jonthomasson/retro1/rev1.a/6502Computer2.png

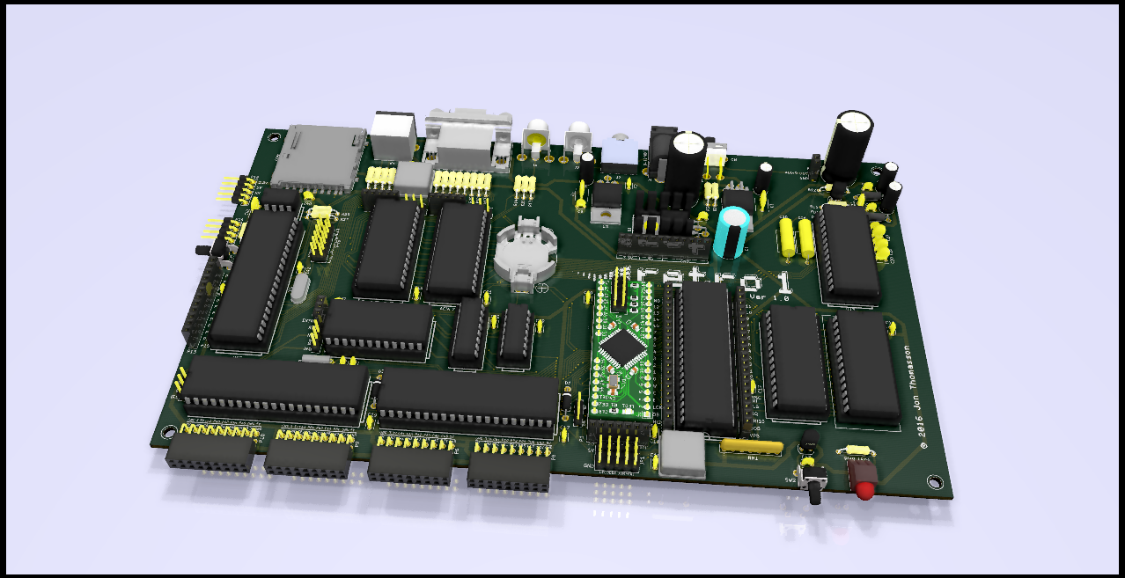
rev1.a/6502Computer2.png
