jonthomasson/retro1/rev1.a/6502Computer_raytraced.jpg

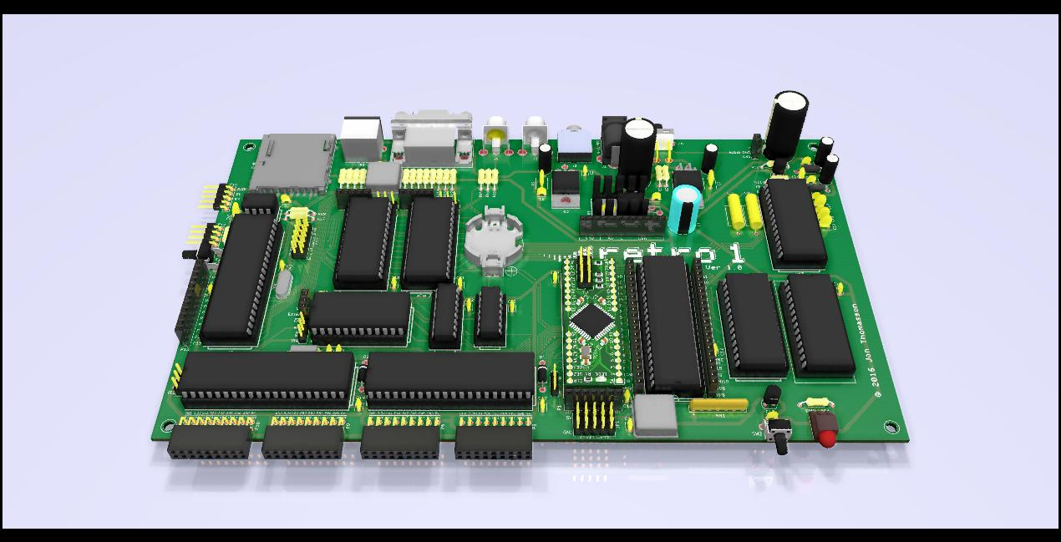
rev1.a/6502Computer_raytraced.jpg
