jonthomasson/retro1/rev1.a/3dfinished/6502Computer_0.png

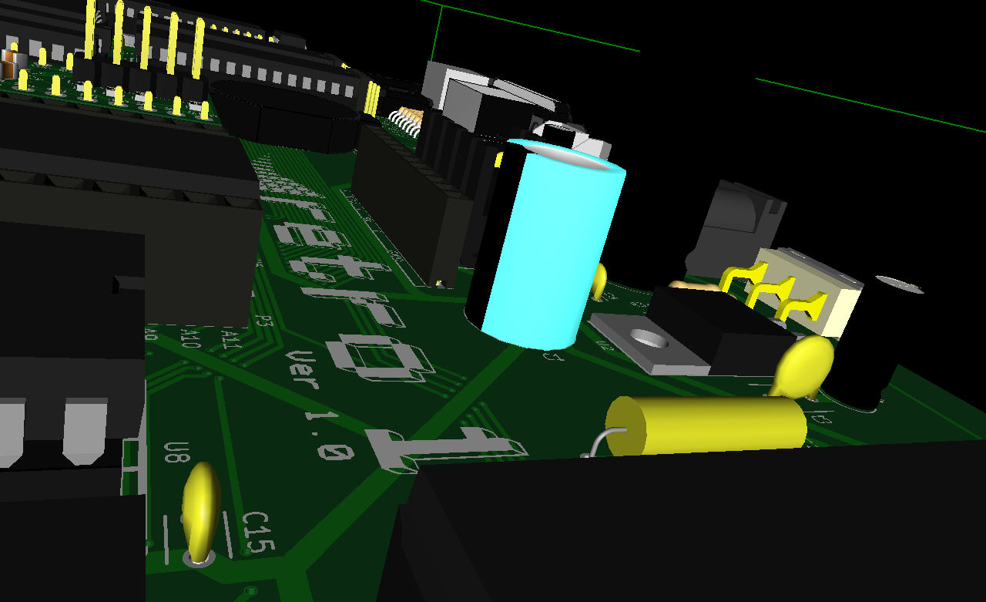
rev1.a/3dfinished/6502Computer_0.png
