jonthomasson/retro1/rev1.a/3dfinished/6502Computer_1.png

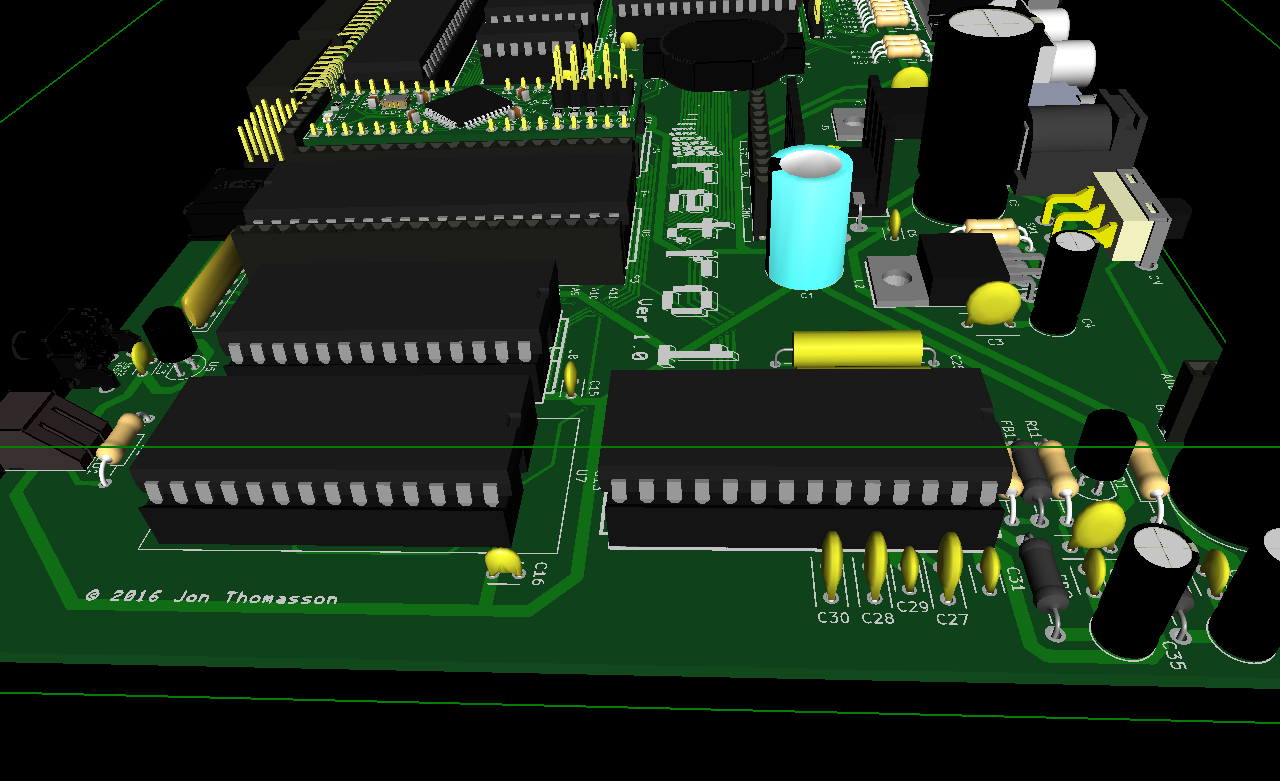
rev1.a/3dfinished/6502Computer_1.png
