jonthomasson/retro1/rev1.a/3dfinished/retro1_1.png

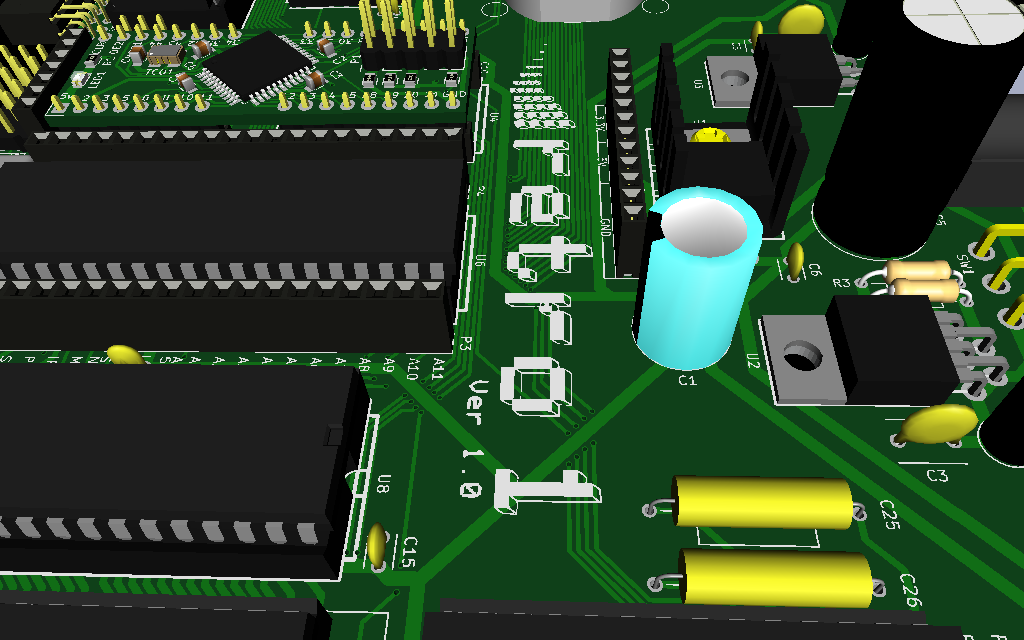
rev1.a/3dfinished/retro1_1.png
