jonthomasson/retro1/rev1.a/3dfinished/retro1_2.png

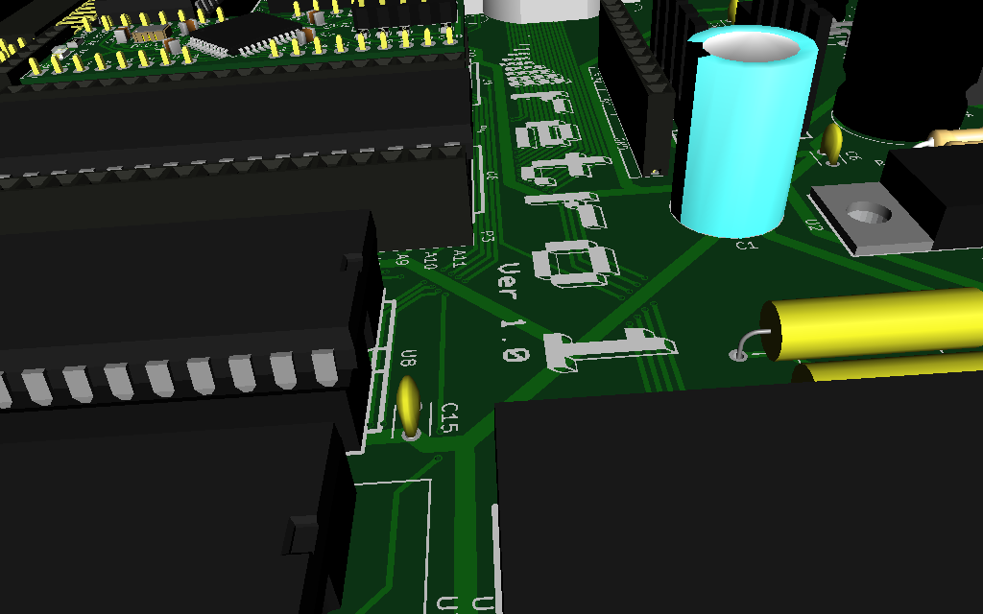
rev1.a/3dfinished/retro1_2.png
