jonthomasson/retro1/rev1.a/6502Computer.jpg

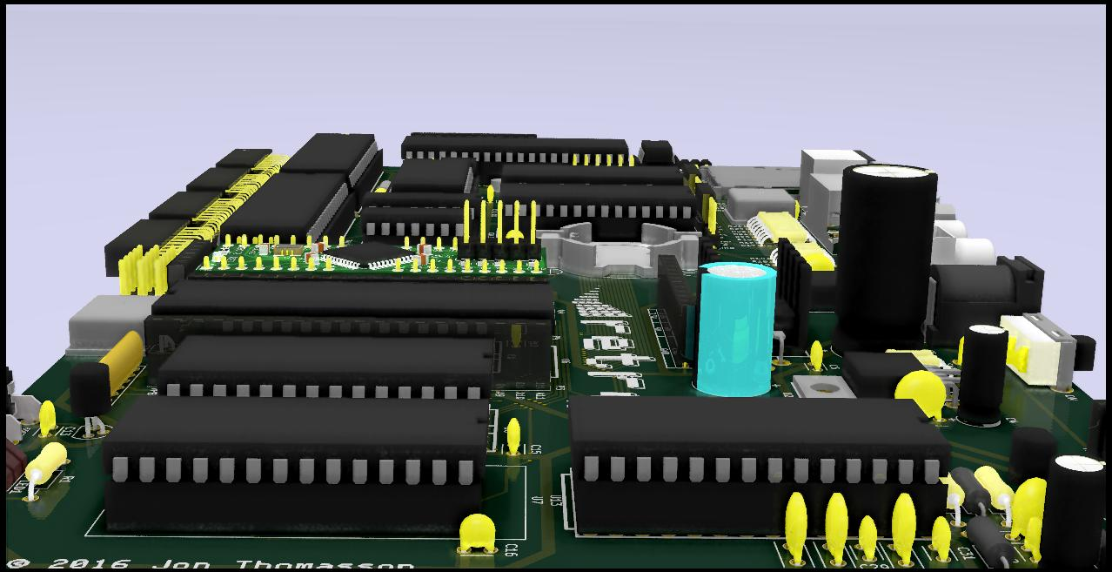
rev1.a/6502Computer.jpg
