jonthomasson/retro1/rev1.a/retro1.dxf

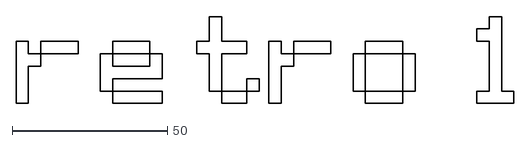
[picture p10: CAD file, 2017-04-14]
rev1.a/retro1.dxf
160.4 x 28.0
