jonthomasson/retro1/(list of files, cad)

Other CAD files:
rev1.a/3dfinished/retro1.dxf
