jonthomasson/retro1/software/retro1-tests/acia-test/screenshot.png

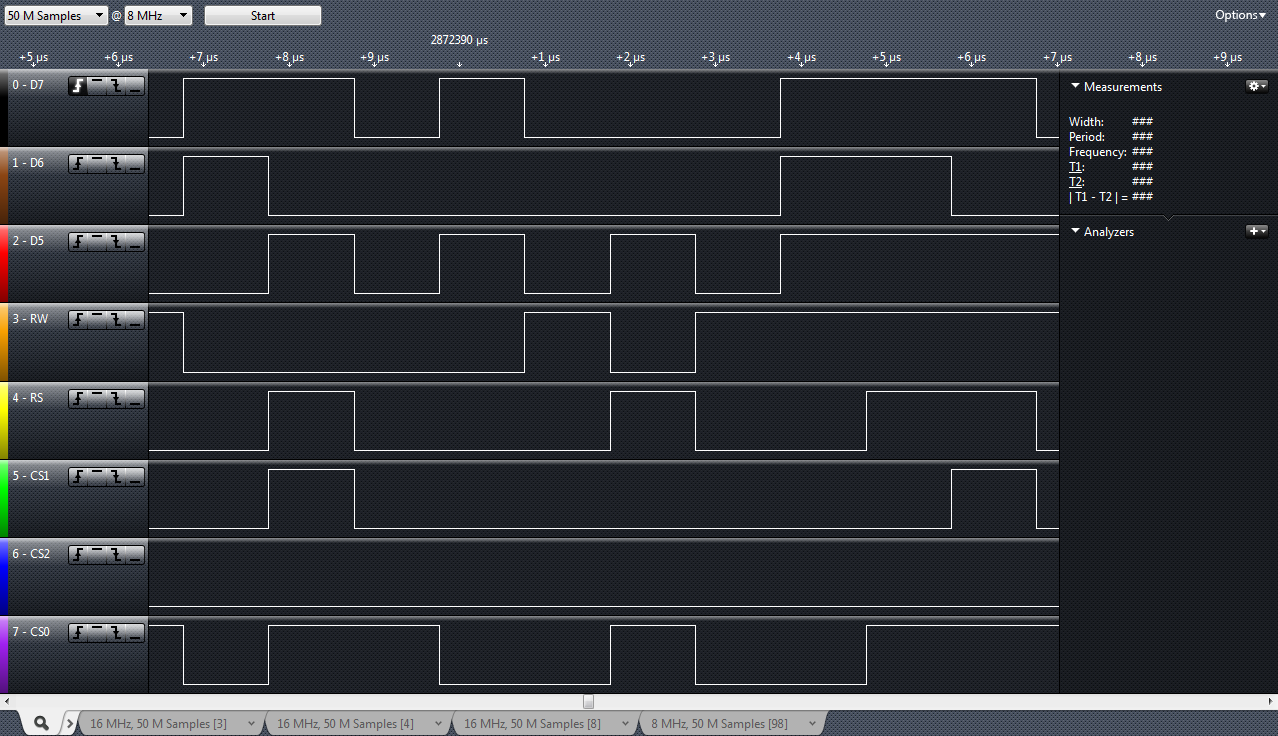
software/retro1-tests/acia-test/screenshot.png
