jonthomasson/retro1/rev1.a/6502Computer.kicad_pcb

## KiCad design rev1.a/6502Computer.kicad_pcb (2017-04-14)

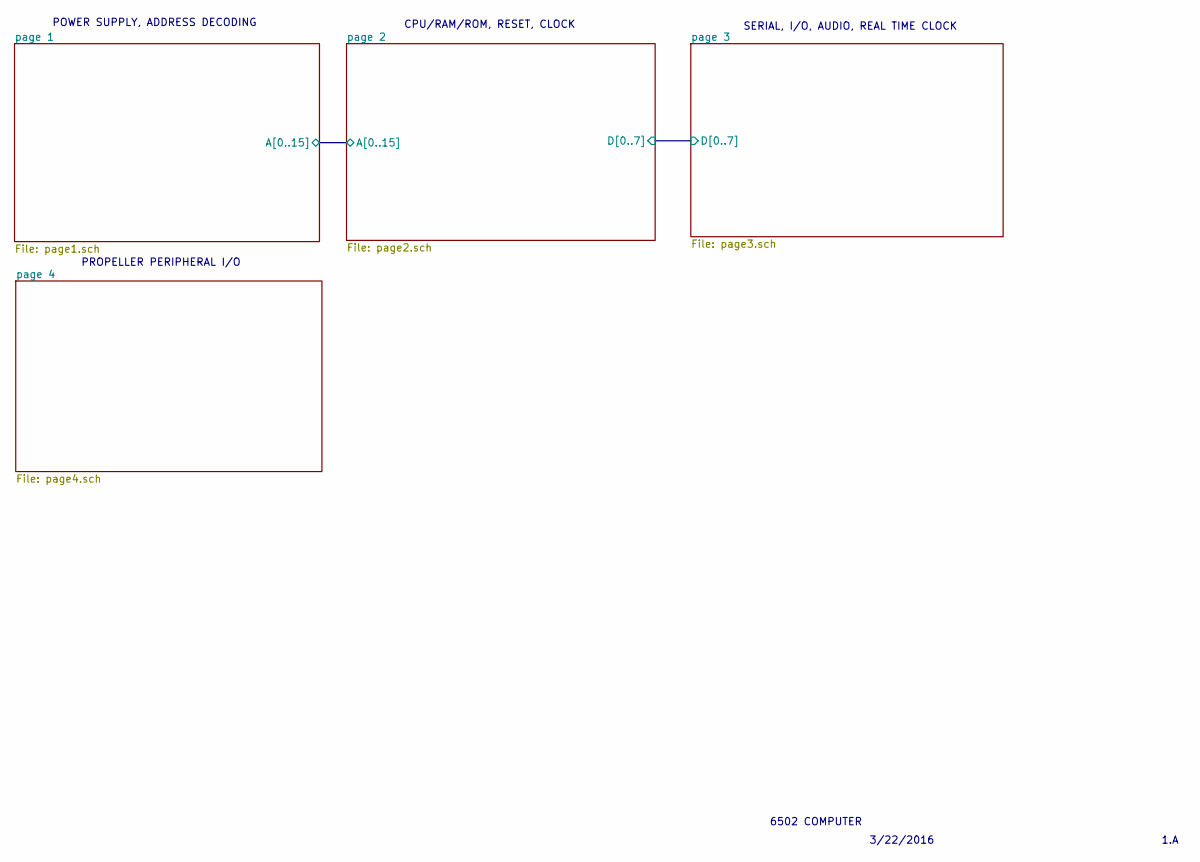
[picture p12: schematic 6502Computer.sch]

Notes on the sheet:
6502 COMPUTER
3/22/2016
1.A
POWER SUPPLY, ADDRESS DECODING
CPU/RAM/ROM, RESET, CLOCK
SERIAL, I/O, AUDIO, REAL TIME CLOCK
PROPELLER PERIPHERAL I/O

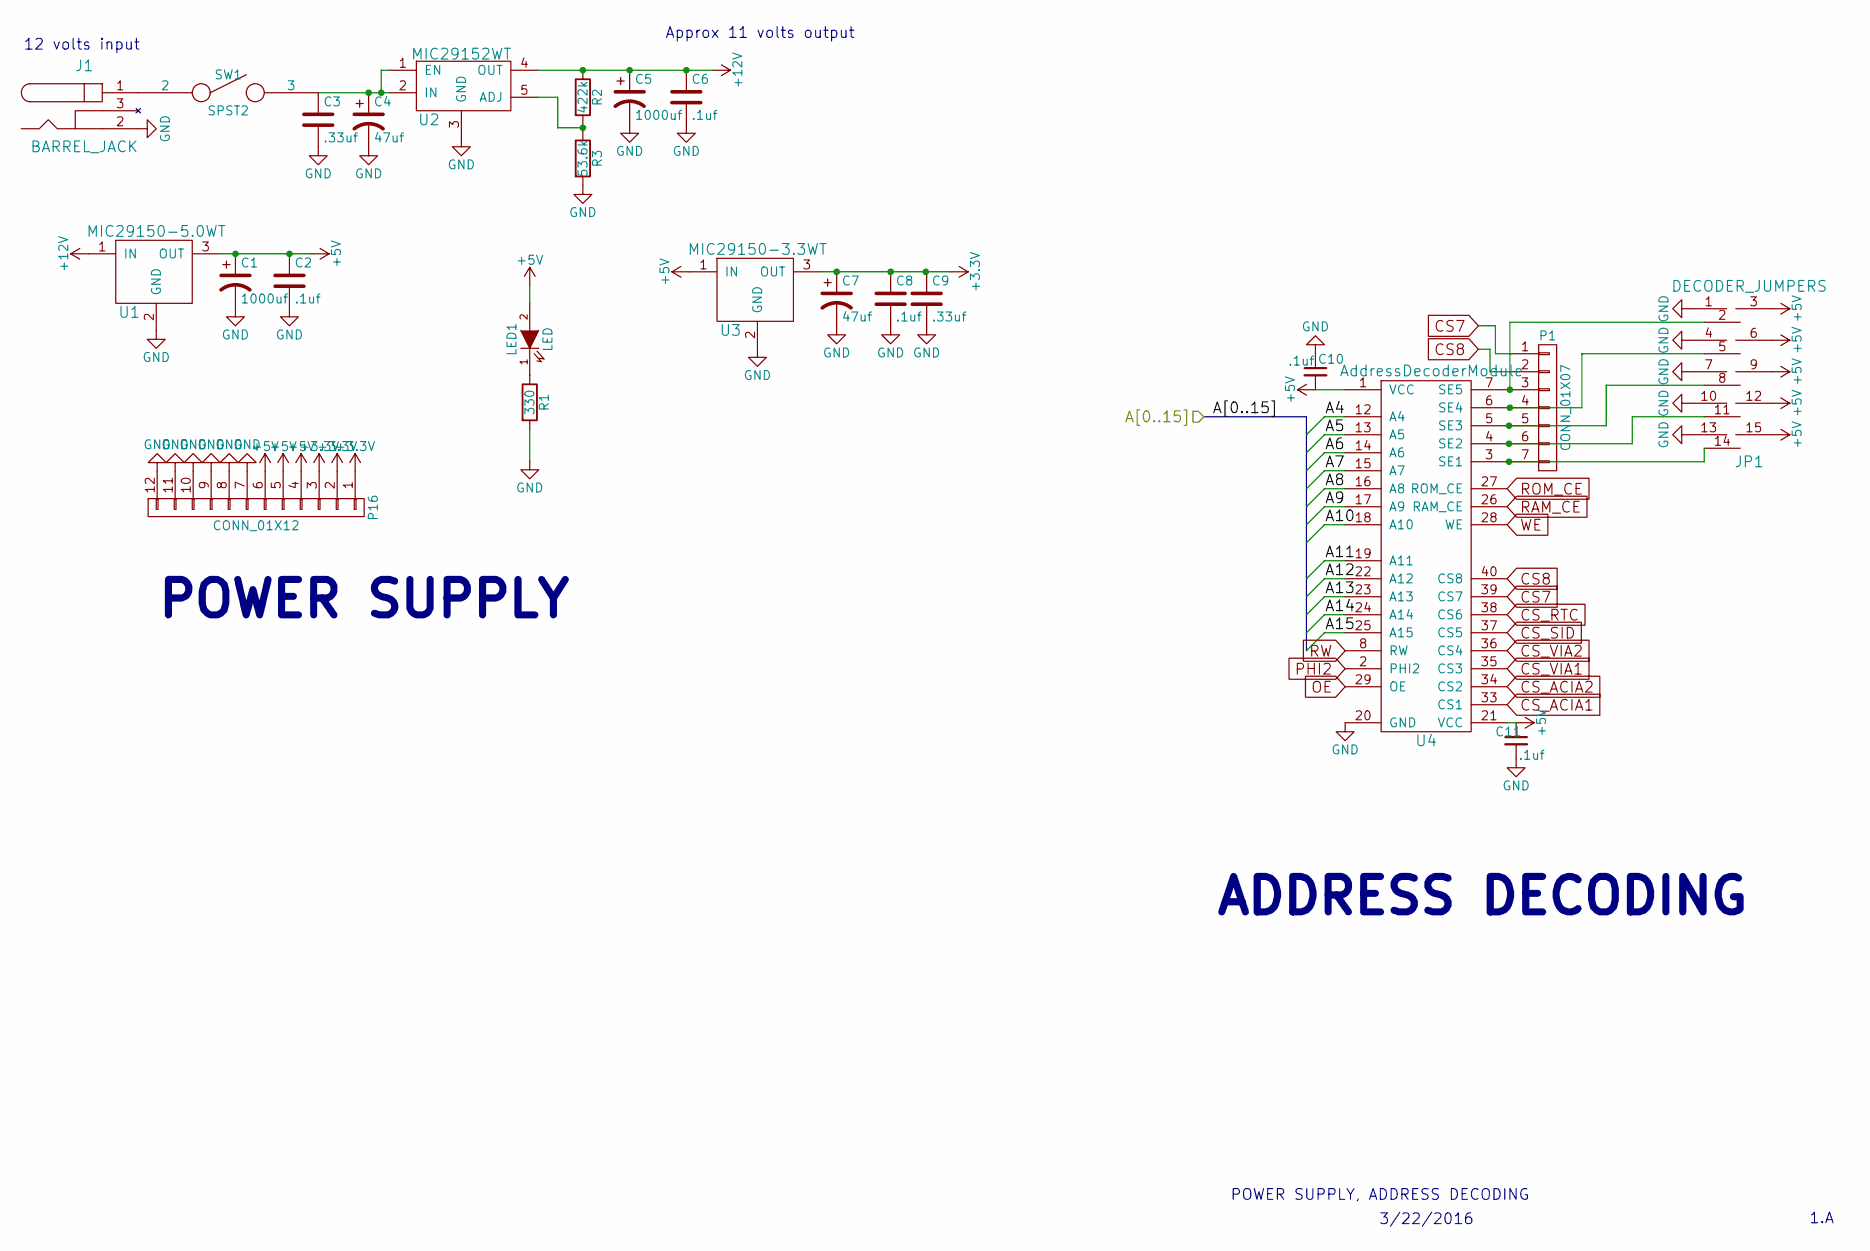
[picture p13: schematic page1.sch]

Parts:
C1: 1000uf; C_Radial_D10_L16_P5
C2, C6, C8, C10, C11: .1uf; C_Disc_D3_P2.5
C3, C9: .33uf; C_Disc_D6_P5
C4, C7: 47uf; C_Radial_D5_L11_P2
C5: 1000uf; C_Radial_D12.5_L25_P5
J1: BARREL_JACK; Barrel_Jack_PJ002A
JP1: DECODER_JUMPERS; Pin_Header_Straight_3x05
LED1: LED; WP1503CB_LED
P1: CONN_01X07; Socket_Strip_Straight_1x07
P16: CONN_01X12; Socket_Strip_Straight_1x12
R1: 330; Resistor_Horizontal_RM10mm
R2: 422k; Resistor_Horizontal_RM10mm
R3: 53.6k; Resistor_Horizontal_RM10mm
SW1: SPST2; SW_Micro_Right_Angle_SPST
U1: MIC29150-5.0WT; to220-horiz_5772
U2: MIC29152WT; to220-5-horiz-notab
U3: MIC29150-3.3WT; to220-horiz-notab
U4: AddressDecoderModule; Address_Decoder_CPLD2

Connections:
+3V3: C7.1, C8.1, C9.1, P16.1, P16.2, P16.3, U3.3 (OUT); also elsewhere on the board
+5V: C1.1, C2.1, C10.2, C11.1, JP1.3, JP1.6, JP1.9, JP1.12, JP1.15, LED1.2 (A), P16.4, P16.5, P16.6, U1.3 (OUT), U3.1 (IN), U4.1 (VCC), U4.21 (VCC); also elsewhere on the board
+12V: C5.1, C6.1, R2.1, U1.1 (IN), U2.4 (OUT); also elsewhere on the board
/page 1/A5: U4.13 (A5); also elsewhere on the board
/page 1/A6: U4.14 (A6); also elsewhere on the board
/page 1/A7: U4.15 (A7); also elsewhere on the board
/page 1/A8: U4.16 (A8); also elsewhere on the board
/page 1/A9: U4.17 (A9); also elsewhere on the board
/page 1/A10: U4.18 (A10); also elsewhere on the board
/page 1/A11: U4.19 (A11); also elsewhere on the board
/page 1/A12: U4.22 (A12); also elsewhere on the board
/page 1/A13: U4.23 (A13); also elsewhere on the board
/page 1/A14: U4.24 (A14); also elsewhere on the board
/page 1/A15: U4.25 (A15); also elsewhere on the board
A4: U4.12 (A4); also elsewhere on the board
CS7: P1.1, U4.39 (CS7)
CS8: P1.2, U4.40 (CS8)
CS_ACIA1: U4.33 (CS1); also elsewhere on the board
CS_ACIA2: U4.34 (CS2); also elsewhere on the board
CS_RTC: U4.38 (CS6); also elsewhere on the board
CS_SID: U4.37 (CS5); also elsewhere on the board
CS_VIA1: U4.35 (CS3); also elsewhere on the board
CS_VIA2: U4.36 (CS4); also elsewhere on the board
GND: C1.2, C2.2, C3.2, C4.2, C5.2, C6.2, C7.2, C8.2, C9.2, C10.1, C11.2, J1.2, JP1.1, JP1.4, JP1.7, JP1.10, JP1.13, P16.7, P16.8, P16.9, P16.10, P16.11, P16.12, R1.2, R3.2, U1.2 (GND), U2.3 (GND), U3.2 (GND), U4.20 (GND); also elsewhere on the board
unnamed: C3.1, C4.1, SW1.3, U2.1 (EN), U2.2 (IN)
unnamed: J1.1, SW1.2
unnamed: JP1.2, P1.3, U4.7 (SE5)
unnamed: JP1.5, P1.4, U4.6 (SE4)
unnamed: JP1.8, P1.5, U4.5 (SE3)
unnamed: JP1.11, P1.6, U4.4 (SE2)
unnamed: JP1.14, P1.7, U4.3 (SE1)
unnamed 105: LED1.1 (K), R1.1; also elsewhere on the board
unnamed: R2.2, R3.1, U2.5 (ADJ)
OE: U4.29 (OE); also elsewhere on the board
PHI2: U4.2 (PHI2); also elsewhere on the board
RAM_CE: U4.26 (RAM_CE); also elsewhere on the board
ROM_CE: U4.27 (ROM_CE); also elsewhere on the board
RW: U4.8 (RW); also elsewhere on the board
WE: U4.28 (WE); also elsewhere on the board

Notes on the sheet:
ADDRESS DECODING
POWER SUPPLY
Approx 11 volts output
12 volts input
POWER SUPPLY, ADDRESS DECODING
3/22/2016
1.A

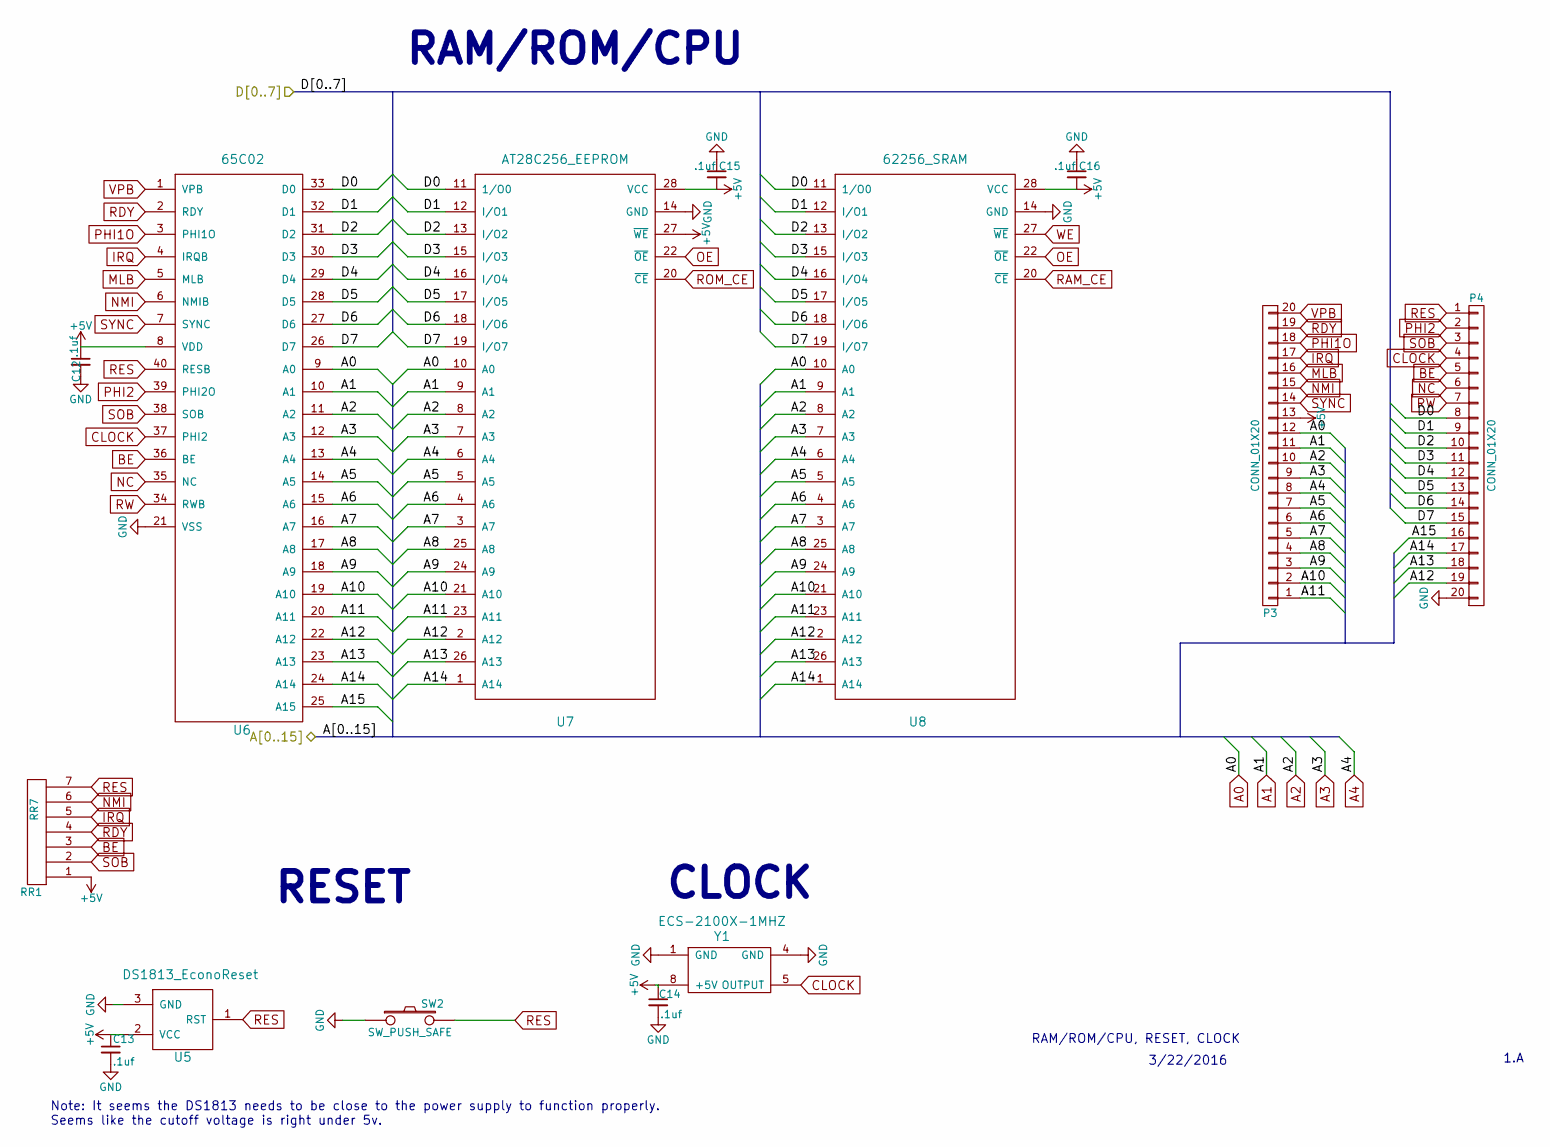
[picture p14: schematic page2.sch]

Parts:
C12, C13, C14, C15, C16: .1uf; C_Disc_D3_P2.5
P3, P4: CONN_01X20; Socket_Strip_Straight_1x20
RR1: RR7; 7_pin_resistor_network
SW2: SW_PUSH_SAFE; 1-1825027-1-TACTILE_SWITCH
U5: DS1813_EconoReset; TO-92_Molded_Narrow
U6: 65C02; dil_40-600_socket
U7: AT28C256_EEPROM; 28-526-11-SOCKET
U8: 62256_SRAM; dil_28-600_socket
Y1: ECS-2100X-1MHZ; ECS-2100AX

Connections:
+5V: C12.1, C13.1, C14.1, C15.2, C16.2, P3.13, RR1.1 (COM), U5.2 (VCC), U6.8 (VDD), U7.27 (~WE), U7.28 (VCC), U8.28 (VCC), Y1.8 (+5V); also elsewhere on the board
/page 1/A5: P3.7, U6.14 (A5), U7.5 (A5), U8.5 (A5); also elsewhere on the board
/page 1/A6: P3.6, U6.15 (A6), U7.4 (A6), U8.4 (A6); also elsewhere on the board
/page 1/A7: P3.5, U6.16 (A7), U7.3 (A7), U8.3 (A7); also elsewhere on the board
/page 1/A8: P3.4, U6.17 (A8), U7.25 (A8), U8.25 (A8); also elsewhere on the board
/page 1/A9: P3.3, U6.18 (A9), U7.24 (A9), U8.24 (A9); also elsewhere on the board
/page 1/A10: P3.2, U6.19 (A10), U7.21 (A10), U8.21 (A10); also elsewhere on the board
/page 1/A11: P3.1, U6.20 (A11), U7.23 (A11), U8.23 (A11); also elsewhere on the board
/page 1/A12: P4.19, U6.22 (A12), U7.2 (A12), U8.2 (A12); also elsewhere on the board
/page 1/A13: P4.18, U6.23 (A13), U7.26 (A13), U8.26 (A13); also elsewhere on the board
/page 1/A14: P4.17, U6.24 (A14), U7.1 (A14), U8.1 (A14); also elsewhere on the board
/page 1/A15: P4.16, U6.25 (A15); also elsewhere on the board
/page 2/D0: P4.8, U6.33 (D0), U7.11 (1/O0), U8.11 (1/O0); also elsewhere on the board
/page 2/D1: P4.9, U6.32 (D1), U7.12 (I/O1), U8.12 (I/O1); also elsewhere on the board
/page 2/D2: P4.10, U6.31 (D2), U7.13 (I/O2), U8.13 (I/O2); also elsewhere on the board
/page 2/D3: P4.11, U6.30 (D3), U7.15 (I/O3), U8.15 (I/O3); also elsewhere on the board
/page 2/D4: P4.12, U6.29 (D4), U7.16 (I/O4), U8.16 (I/O4); also elsewhere on the board
/page 2/D5: P4.13, U6.28 (D5), U7.17 (I/O5), U8.17 (I/O5); also elsewhere on the board
/page 2/D6: P4.14, U6.27 (D6), U7.18 (I/O6), U8.18 (I/O6); also elsewhere on the board
/page 2/D7: P4.15, U6.26 (D7), U7.19 (I/O7), U8.19 (I/O7); also elsewhere on the board
A0: P3.12, U6.9 (A0), U7.10 (A0), U8.10 (A0); also elsewhere on the board
A1: P3.11, U6.10 (A1), U7.9 (A1), U8.9 (A1); also elsewhere on the board
A2: P3.10, U6.11 (A2), U7.8 (A2), U8.8 (A2); also elsewhere on the board
A3: P3.9, U6.12 (A3), U7.7 (A3), U8.7 (A3); also elsewhere on the board
A4: P3.8, U6.13 (A4), U7.6 (A4), U8.6 (A4); also elsewhere on the board
BE: P4.5, RR1.3, U6.36 (BE)
CLOCK: P4.4, U6.37 (PHI2), Y1.5 (OUTPUT)
GND: C12.2, C13.2, C14.2, C15.1, C16.1, P4.20, SW2.1, U5.3 (GND), U6.21 (VSS), U7.14 (GND), U8.14 (GND), Y1.1 (GND), Y1.4 (GND); also elsewhere on the board
IRQ: P3.17, RR1.5, U6.4 (IRQB); also elsewhere on the board
MLB: P3.16, U6.5 (MLB)
NC: P4.6, U6.35 (NC)
NMI: P3.15, RR1.6, U6.6 (NMIB); also elsewhere on the board
OE: U7.22 (~OE), U8.22 (~OE); also elsewhere on the board
PHI1O: P3.18, U6.3 (PHI1O)
PHI2: P4.2, U6.39 (PHI2O); also elsewhere on the board
RAM_CE: U8.20 (~CE); also elsewhere on the board
RDY: P3.19, RR1.4, U6.2 (RDY)
RES: P4.1, RR1.7, SW2.4, U5.1 (RST), U6.40 (RESB); also elsewhere on the board
ROM_CE: U7.20 (~CE); also elsewhere on the board
RW: P4.7, U6.34 (RWB); also elsewhere on the board
SOB: P4.3, RR1.2, U6.38 (SOB)
SYNC: P3.14, U6.7 (SYNC)
VPB: P3.20, U6.1 (VPB)
WE: U8.27 (~WE); also elsewhere on the board

Notes on the sheet:
RAM/ROM/CPU
CLOCK
RESET
Note: It seems the DS1813 needs to be close to the power supply to function properly. Seems like the cutoff voltage is right under 5v.
RAM/ROM/CPU, RESET, CLOCK
3/22/2016
1.A

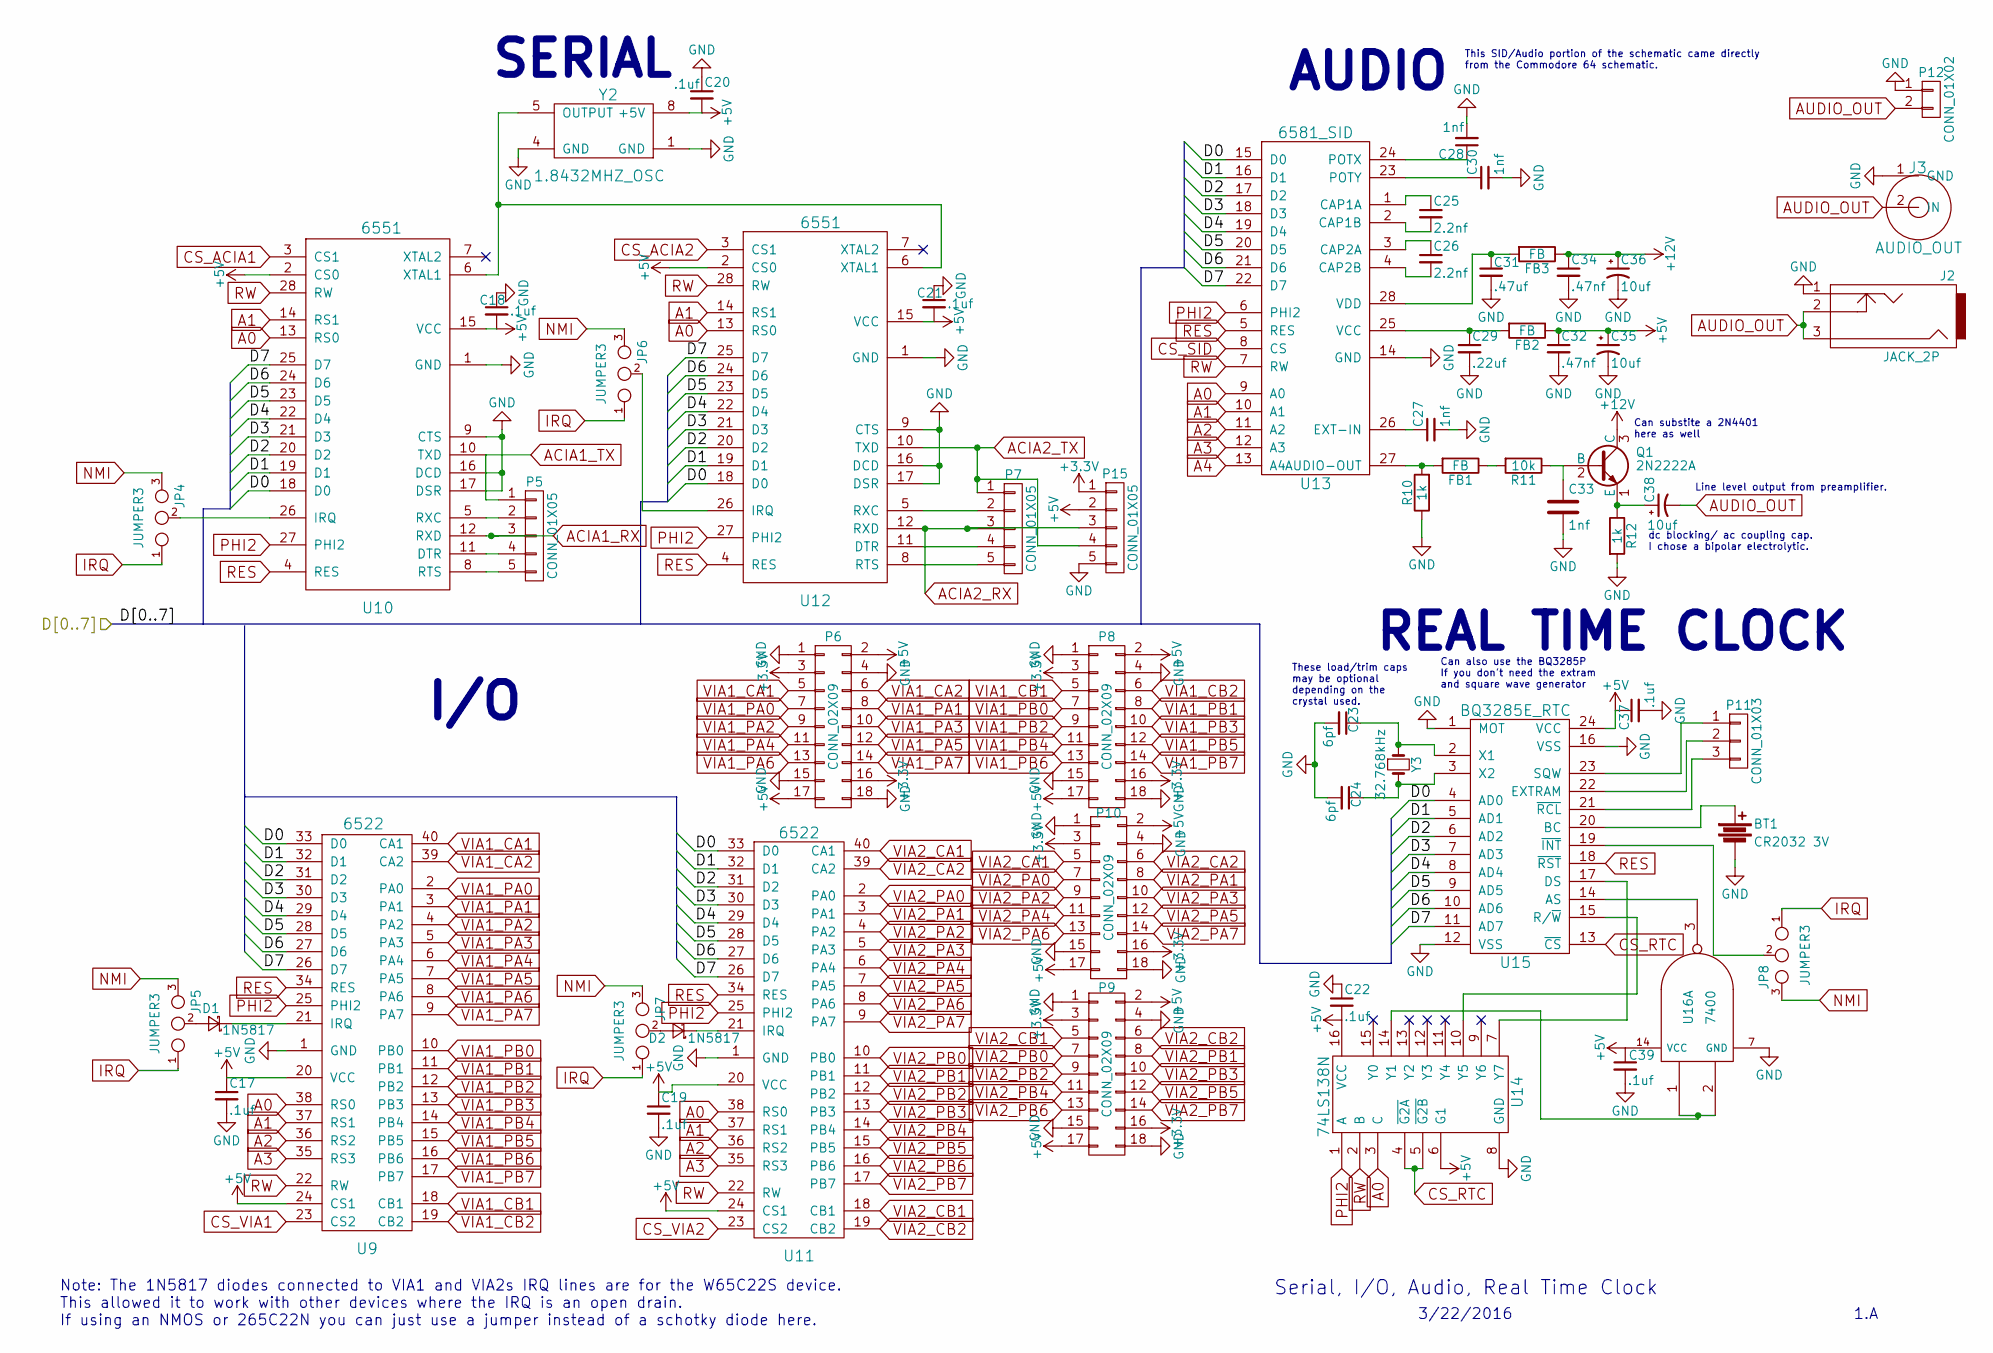
[picture p15: schematic page3.sch]

Parts:
BT1: CR2032 3V; BU2032SM
C17, C18, C19, C20, C21, C22, C37, C39: .1uf; C_Disc_D3_P2.5
C23, C24: 6pf; C_Disc_D3_P2.5
C25, C26: 2.2nf; C_Axial_D6_L11_P18
C27, C28, C30, C33: 1nf; C_Disc_D6_P3.5_Skinny
C29: .22uf; C_Disc_D3_P2.5
C31: .47uf; C_Disc_D3_P2.5
C32, C34: .47nf; C_Disc_D3_P2.5
C35, C36: 10uf; C_Radial_D5_L11_P2
C38: 10uf; C_Radial_D12.5_L25_P5
D1, D2: 1N5817; diode_do41
FB1, FB2, FB3: FB; Ferrite_Bead_Horizontal_RM10mm
J2: JACK_2P; SJ13525NHeadphone
J3: AUDIO_OUT; RCJ013AUDIO
JP4, JP5, JP6, JP7, JP8: JUMPER3; Pin_Header_Straight_1x03
P5, P7: CONN_01X05; Socket_Strip_Straight_1x05
P6, P8, P9, P10: CONN_02X09; Socket_Strip_Angled_2x09
P11: CONN_01X03; Socket_Strip_Straight_1x03
P12: CONN_01X02; Socket_Strip_Straight_1x02
P15: CONN_01X05; Pin_Header_Angled_1x05
Q1: 2N2222A; TO-92_Molded_Narrow
R10, R12: 1k; Resistor_Horizontal_RM10mm
R11: 10k; Resistor_Horizontal_RM10mm
U9, U11: 6522; dil_40-600_socket
U10, U12: 6551; dil_28-600_socket
U13: 6581_SID; dil_28-600_socket
U14: 74LS138N; dil_16-300_socket
U15: BQ3285E_RTC; dil_24-600_socket
U16: 7400; dil_14-300_socket
Y2: 1.8432MHZ_OSC; ECS-2100AX
Y3: 32.768kHz; crystal_tc-38_horiz

Connections:
+3V3: P6.3, P6.16, P8.3, P8.16, P9.3, P9.16, P10.3, P10.16, P15.1; also elsewhere on the board
+5V: C17.1, C18.2, C19.1, C20.2, C21.2, C22.2, C32.1, C35.1, C37.1, C39.1, FB2.1, P6.2, P6.17, P8.2, P8.17, P9.2, P9.17, P10.2, P10.17, P15.2, U9.20 (VCC), U9.24 (CS1), U10.2 (CS0), U10.15 (VCC), U11.20 (VCC), U11.24 (CS1), U12.2 (CS0), U12.15 (VCC), U14.6 (G1), U14.16 (VCC), U15.24 (VCC), U16.14 (VCC), Y2.8 (+5V); also elsewhere on the board
+12V: C34.1, C36.1, FB3.1, Q1.3 (C); also elsewhere on the board
/page 2/D0: U9.33 (D0), U10.18 (D0), U11.33 (D0), U12.18 (D0), U13.15 (D0), U15.4 (AD0); also elsewhere on the board
/page 2/D1: U9.32 (D1), U10.19 (D1), U11.32 (D1), U12.19 (D1), U13.16 (D1), U15.5 (AD1); also elsewhere on the board
/page 2/D2: U9.31 (D2), U10.20 (D2), U11.31 (D2), U12.20 (D2), U13.17 (D2), U15.6 (AD2); also elsewhere on the board
/page 2/D3: U9.30 (D3), U10.21 (D3), U11.30 (D3), U12.21 (D3), U13.18 (D3), U15.7 (AD3); also elsewhere on the board
/page 2/D4: U9.29 (D4), U10.22 (D4), U11.29 (D4), U12.22 (D4), U13.19 (D4), U15.8 (AD4); also elsewhere on the board
/page 2/D5: U9.28 (D5), U10.23 (D5), U11.28 (D5), U12.23 (D5), U13.20 (D5), U15.9 (AD5); also elsewhere on the board
/page 2/D6: U9.27 (D6), U10.24 (D6), U11.27 (D6), U12.24 (D6), U13.21 (D6), U15.10 (AD6); also elsewhere on the board
/page 2/D7: U9.26 (D7), U10.25 (D7), U11.26 (D7), U12.25 (D7), U13.22 (D7), U15.11 (AD7); also elsewhere on the board
A0: U9.38 (RS0), U10.13 (RS0), U11.38 (RS0), U12.13 (RS0), U13.9 (A0), U14.3 (C); also elsewhere on the board
A1: U9.37 (RS1), U10.14 (RS1), U11.37 (RS1), U12.14 (RS1), U13.10 (A1); also elsewhere on the board
A2: U9.36 (RS2), U11.36 (RS2), U13.11 (A2); also elsewhere on the board
A3: U9.35 (RS3), U11.35 (RS3), U13.12 (A3); also elsewhere on the board
A4: U13.13 (A4); also elsewhere on the board
ACIA1_RX: P5.3, U10.12 (RXD); also elsewhere on the board
ACIA1_TX: P5.1, U10.10 (TXD); also elsewhere on the board
ACIA2_RX: P7.3, P15.3, U12.12 (RXD); also elsewhere on the board
ACIA2_TX: P7.1, P15.4, U12.10 (TXD); also elsewhere on the board
AUDIO_OUT: C38.2, J2.2, J2.3, J3.2 (IN), P12.2
CS_RTC: U14.4 (~G2A), U14.5 (~G2B), U15.13 (~CS); also elsewhere on the board
CS_SID: U13.8 (CS); also elsewhere on the board
CS_VIA1: U9.23 (CS2); also elsewhere on the board
CS_VIA2: U11.23 (CS2); also elsewhere on the board
GND: BT1.2, C17.2, C18.1, C19.2, C20.1, C21.1, C22.1, C23.2, C24.2, C27.2, C28.2, C29.2, C30.2, C31.2, C32.2, C33.2, C34.2, C35.2, C36.2, C37.2, C39.2, J2.1, J3.1 (GND), P6.1, P6.4, P6.15, P6.18, P8.1, P8.4, P8.15, P8.18, P9.1, P9.4, P9.15, P9.18, P10.1, P10.4, P10.15, P10.18, P12.1, P15.5, R10.1, R12.2, U9.1 (GND), U10.1 (GND), U10.9 (CTS), U10.16 (DCD), U10.17 (DSR), U11.1 (GND), U12.1 (GND), U12.9 (CTS), U12.16 (DCD), U12.17 (DSR), U13.14 (GND), U14.8 (GND), U15.1 (MOT), U15.12 (VSS), U15.16 (VSS), U16.7 (GND), Y2.1 (GND), Y2.4 (GND); also elsewhere on the board
IRQ: JP4.1, JP5.1, JP6.1, JP7.1, JP8.1; also elsewhere on the board
NMI: JP4.3, JP5.3, JP6.3, JP7.3, JP8.3; also elsewhere on the board
unnamed: BT1.1, U15.20 (BC)
unnamed: C23.1, U15.2 (X1), Y3.1
unnamed: C24.1, U15.3 (X2), Y3.2
unnamed: C25.1, U13.1 (CAP1A)
unnamed: C25.2, U13.2 (CAP1B)
unnamed: C26.1, U13.3 (CAP2A)
unnamed: C26.2, U13.4 (CAP2B)
unnamed: C27.1, U13.26 (EXT-IN)
unnamed: C28.1, U13.24 (POTX)
unnamed: C29.1, FB2.2, U13.25 (VCC)
unnamed: C30.1, U13.23 (POTY)
unnamed: C31.1, FB3.2, U13.28 (VDD)
unnamed: C33.1, Q1.2 (B), R11.1
unnamed: C38.1, Q1.1 (E), R12.1
unnamed: D1.1 (K), U9.21 (IRQ)
unnamed: D1.2 (A), JP5.2
unnamed: D2.1 (K), U11.21 (IRQ)
unnamed: D2.2 (A), JP7.2
unnamed: FB1.1, R11.2
unnamed: FB1.2, R10.2, U13.27 (AUDIO-OUT)
unnamed 91: JP4.2, U10.26 (IRQ); also elsewhere on the board
unnamed 92: JP6.2, U12.26 (IRQ); also elsewhere on the board
unnamed: JP8.2, U15.19 (~INT)
unnamed 106: P5.2, U10.5 (RXC); also elsewhere on the board
unnamed 107: P5.4, U10.11 (DTR); also elsewhere on the board
unnamed 108: P5.5, U10.8 (RTS); also elsewhere on the board
unnamed 109: P7.2, U12.5 (RXC); also elsewhere on the board
unnamed 110: P7.4, U12.11 (DTR); also elsewhere on the board
unnamed 111: P7.5, U12.8 (RTS); also elsewhere on the board
unnamed: P11.1, U15.23 (SQW)
unnamed: P11.2, U15.22 (EXTRAM)
unnamed: P11.3, U15.21 (~RCL)
unnamed 137: U10.6 (XTAL1), U12.6 (XTAL1), Y2.5 (OUTPUT); also elsewhere on the board
unnamed: U14.7 (Y7), U15.17 (DS)
unnamed: U14.10 (Y5), U15.15 (R/~W)
unnamed: U14.14 (Y1), U16.1, U16.2
unnamed: U15.14 (AS), U16.3
PHI2: U9.25 (PHI2), U10.27 (PHI2), U11.25 (PHI2), U12.27 (PHI2), U13.6 (PHI2), U14.1 (A); also elsewhere on the board
RES: U9.34 (RES), U10.4 (RES), U11.34 (RES), U12.4 (RES), U13.5 (RES), U15.18 (~RST); also elsewhere on the board
RW: U9.22 (RW), U10.28 (RW), U11.22 (RW), U12.28 (RW), U13.7 (RW), U14.2 (B); also elsewhere on the board
VIA1_CA1: P6.5, U9.40 (CA1)
VIA1_CA2: P6.6, U9.39 (CA2)
VIA1_CB1: P8.5, U9.18 (CB1)
VIA1_CB2: P8.6, U9.19 (CB2)
VIA1_PA0: P6.7, U9.2 (PA0)
VIA1_PA1: P6.8, U9.3 (PA1)
VIA1_PA2: P6.9, U9.4 (PA2)
VIA1_PA3: P6.10, U9.5 (PA3)
VIA1_PA4: P6.11, U9.6 (PA4)
VIA1_PA5: P6.12, U9.7 (PA5)
VIA1_PA6: P6.13, U9.8 (PA6)
VIA1_PA7: P6.14, U9.9 (PA7)
VIA1_PB0: P8.7, U9.10 (PB0)
VIA1_PB1: P8.8, U9.11 (PB1)
VIA1_PB2: P8.9, U9.12 (PB2)
VIA1_PB3: P8.10, U9.13 (PB3)
VIA1_PB4: P8.11, U9.14 (PB4)
VIA1_PB5: P8.12, U9.15 (PB5)
VIA1_PB6: P8.13, U9.16 (PB6)
VIA1_PB7: P8.14, U9.17 (PB7)
VIA2_CA1: P10.5, U11.40 (CA1)
VIA2_CA2: P10.6, U11.39 (CA2)
VIA2_CB1: P9.5, U11.18 (CB1)
VIA2_CB2: P9.6, U11.19 (CB2)
VIA2_PA0: P10.7, U11.2 (PA0)
VIA2_PA1: P10.8, U11.3 (PA1)
VIA2_PA2: P10.9, U11.4 (PA2)
VIA2_PA3: P10.10, U11.5 (PA3)
VIA2_PA4: P10.11, U11.6 (PA4)
VIA2_PA5: P10.12, U11.7 (PA5)
VIA2_PA6: P10.13, U11.8 (PA6)
VIA2_PA7: P10.14, U11.9 (PA7)
VIA2_PB0: P9.7, U11.10 (PB0)
VIA2_PB1: P9.8, U11.11 (PB1)
VIA2_PB2: P9.9, U11.12 (PB2)
VIA2_PB3: P9.10, U11.13 (PB3)
VIA2_PB4: P9.11, U11.14 (PB4)
VIA2_PB5: P9.12, U11.15 (PB5)
VIA2_PB6: P9.13, U11.16 (PB6)
VIA2_PB7: P9.14, U11.17 (PB7)

Notes on the sheet:
AUDIO
I/O
SERIAL
REAL TIME CLOCK
Note: The 1N5817 diodes connected to VIA1 and VIA2s IRQ lines are for the W65C22S device. This allowed it to work with other devices where the IRQ is an open drain. If using an NMOS or 265C22N you can just use a jumper instead of a schotky diode here.
Can substite a 2N4401 here as well
Can also use the BQ3285P If you don't need the extram and square wave generator
This SID/Audio portion of the schematic came directly from the Commodore 64 schematic.
These load/trim caps may be optional depending on the crystal used.
Serial, I/O, Audio, Real Time Clock
3/22/2016
1.A
dc blocking/ ac coupling cap. I chose a bipolar electrolytic.
Line level output from preamplifier.

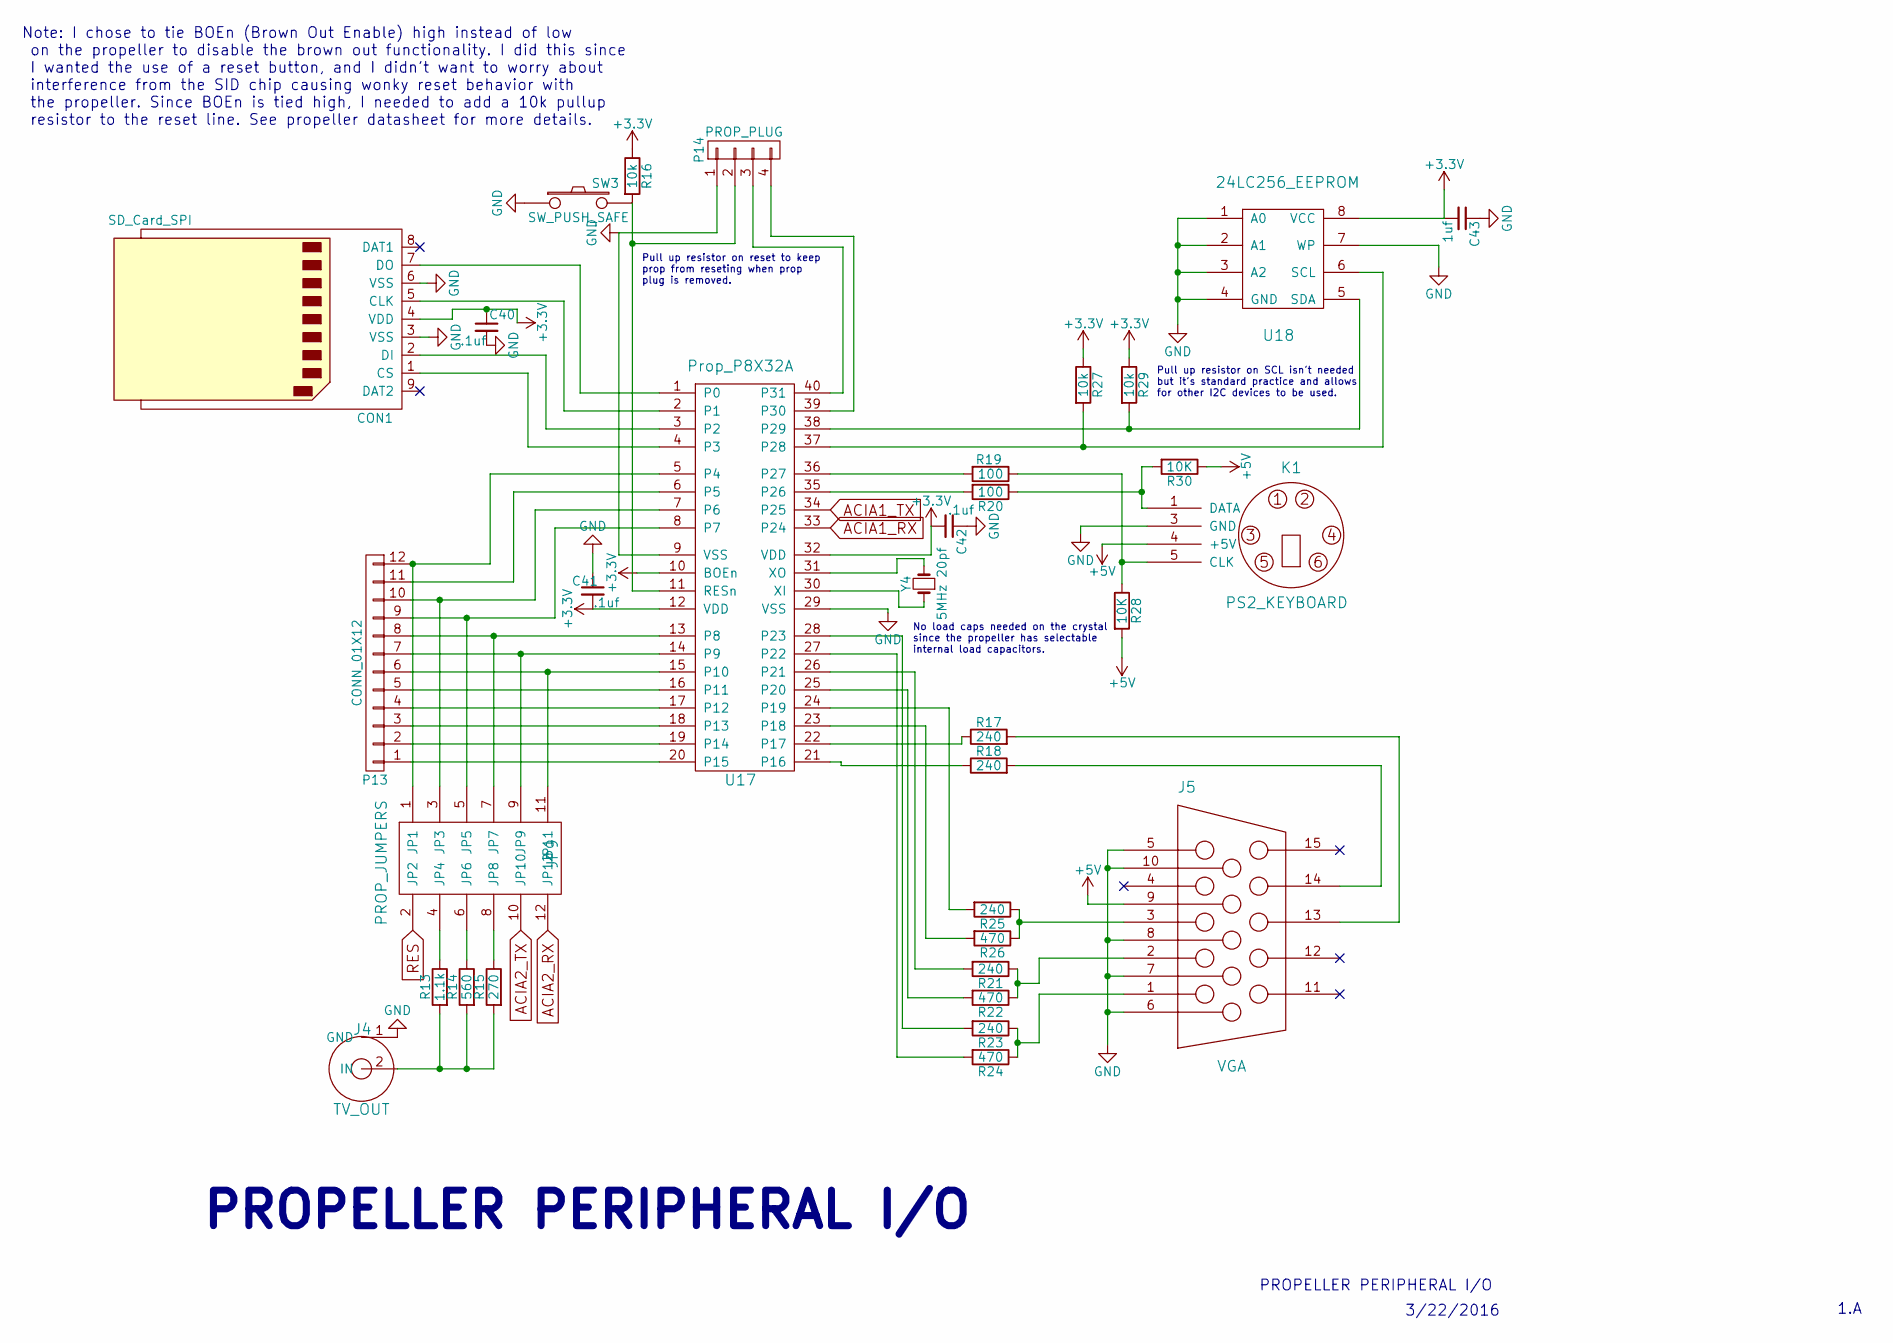
[picture p16: schematic page4.sch]

Parts:
C40, C41, C42: .1uf; C_Disc_D3_P2.5
C43: 1uf; C_Disc_D6_P5
CON1: SD_Card_SPI; DM1AASFPEJ_SDCARD
J4: TV_OUT; RCJ014VIDEO
J5: VGA; 117343442VGA
JP9: PROP_JUMPERS; Pin_Header_Straight_2x06
K1: PS2_KEYBOARD; MD60SM
P13: CONN_01X12; Socket_Strip_Straight_1x12
P14: PROP_PLUG
R13: 1.1k; Resistor_Horizontal_RM10mm
R14: 560; Resistor_Horizontal_RM10mm
R15: 270; Resistor_Horizontal_RM10mm
R16, R27, R29: 10k; Resistor_Horizontal_RM10mm
R17, R18, R21, R23, R25: 240; Resistor_Horizontal_RM10mm
R19, R20: 100; Resistor_Horizontal_RM10mm
R22, R24, R26: 470; Resistor_Horizontal_RM10mm
R28, R30: 10K; Resistor_Horizontal_RM10mm
SW3: SW_PUSH_SAFE; 1-1825027-1-TACTILE_SWITCH
U17: Prop_P8X32A; dil_40-600_socket
U18: 24LC256_EEPROM; dil_8-300_socket
Y4: 5MHz 20pf; crystal_hc-49s

Connections:
+3V3: C40.1, C41.2, C42.2, C43.2, CON1.4 (VDD), R16.1, R27.1, R29.1, U17.10 (BOEn), U17.12 (VDD), U17.32 (VDD), U18.8 (VCC); also elsewhere on the board
+5V: J5.9 (KEY/PWR), K1.4 (+5V), R28.2, R30.1; also elsewhere on the board
ACIA1_RX: U17.33 (P24); also elsewhere on the board
ACIA1_TX: U17.34 (P25); also elsewhere on the board
ACIA2_RX: JP9.12 (JP12); also elsewhere on the board
ACIA2_TX: JP9.10 (JP10); also elsewhere on the board
GND: C40.2, C41.1, C42.1, C43.1, CON1.3 (VSS), CON1.6 (VSS), J4.1 (GND), J5.5 (GND_HSYNC), J5.6 (RED_RTN), J5.7 (GREEN_RTN), J5.8 (BLUE_RTN), J5.10 (GND_VSYNC), K1.3 (GND), P14.1, SW3.1, U17.9 (VSS), U17.29 (VSS), U18.1 (A0), U18.2 (A1), U18.3 (A2), U18.4 (GND), U18.7 (WP); also elsewhere on the board
unnamed: CON1.1 (CS), U17.4 (P3)
unnamed: CON1.2 (DI), U17.3 (P2)
unnamed: CON1.5 (CLK), U17.2 (P1)
unnamed: CON1.7 (DO), U17.1 (P0)
unnamed: J4.2 (IN), R13.2, R14.2, R15.2
unnamed: J5.1 (RED), R23.1, R24.1
unnamed: J5.2 (GREEN), R21.1, R22.1
unnamed: J5.3 (BLUE), R25.1, R26.1
unnamed: J5.13 (HSYNC), R17.2
unnamed: J5.14 (VSYNC), R18.2
unnamed: JP9.1 (JP1), P13.12, U17.5 (P4)
unnamed: JP9.3 (JP3), P13.10, U17.7 (P6)
unnamed: JP9.4 (JP4), R13.1
unnamed: JP9.5 (JP5), P13.9, U17.8 (P7)
unnamed: JP9.6 (JP6), R14.1
unnamed: JP9.7 (JP7), P13.8, U17.13 (P8)
unnamed: JP9.8 (JP8), R15.1
unnamed: JP9.9 (JP9), P13.7, U17.14 (P9)
unnamed: JP9.11 (JP11), P13.6, U17.15 (P10)
unnamed: K1.1 (DATA), R20.1, R30.2
unnamed: K1.5 (CLK), R19.1, R28.1
unnamed: P13.1, U17.20 (P15)
unnamed: P13.2, U17.19 (P14)
unnamed: P13.3, U17.18 (P13)
unnamed: P13.4, U17.17 (P12)
unnamed: P13.5, U17.16 (P11)
unnamed: P13.11, U17.6 (P5)
unnamed: P14.2, R16.2, SW3.4, U17.11 (RESn)
unnamed: P14.3, U17.40 (P31)
unnamed: P14.4, U17.39 (P30)
unnamed: R17.1, U17.22 (P17)
unnamed: R18.1, U17.21 (P16)
unnamed: R19.2, U17.36 (P27)
unnamed: R20.2, U17.35 (P26)
unnamed: R21.2, U17.26 (P21)
unnamed: R22.2, U17.25 (P20)
unnamed: R23.2, U17.28 (P23)
unnamed: R24.2, U17.27 (P22)
unnamed: R25.2, U17.24 (P19)
unnamed: R26.2, U17.23 (P18)
unnamed: R27.2, U17.37 (P28), U18.6 (SCL)
unnamed: R29.2, U17.38 (P29), U18.5 (SDA)
unnamed: U17.30 (XI), Y4.1
unnamed: U17.31 (XO), Y4.2
RES: JP9.2 (JP2); also elsewhere on the board

Notes on the sheet:
PROPELLER PERIPHERAL I/O
Note: I chose to tie BOEn (Brown Out Enable) high instead of low on the propeller to disable the brown out functionality. I did this since I wanted the use of a reset button, and I didn't want to worry about interference from the SID chip causing wonky reset behavior with the propeller. Since BOEn 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
No load caps needed on the crystal since the propeller has selectable internal load capacitors.
Pull up resistor on SCL isn't needed but it's standard practice and allows for other I2C devices to be used.
Pull up resistor on reset to keep prop from reseting when prop plug is removed.
3/22/2016
1.A
