jonthomasson/retro1/rev1.a/6502Computer.kicad_pcb

## KiCad design rev1.a/6502Computer.kicad_pcb (continued)

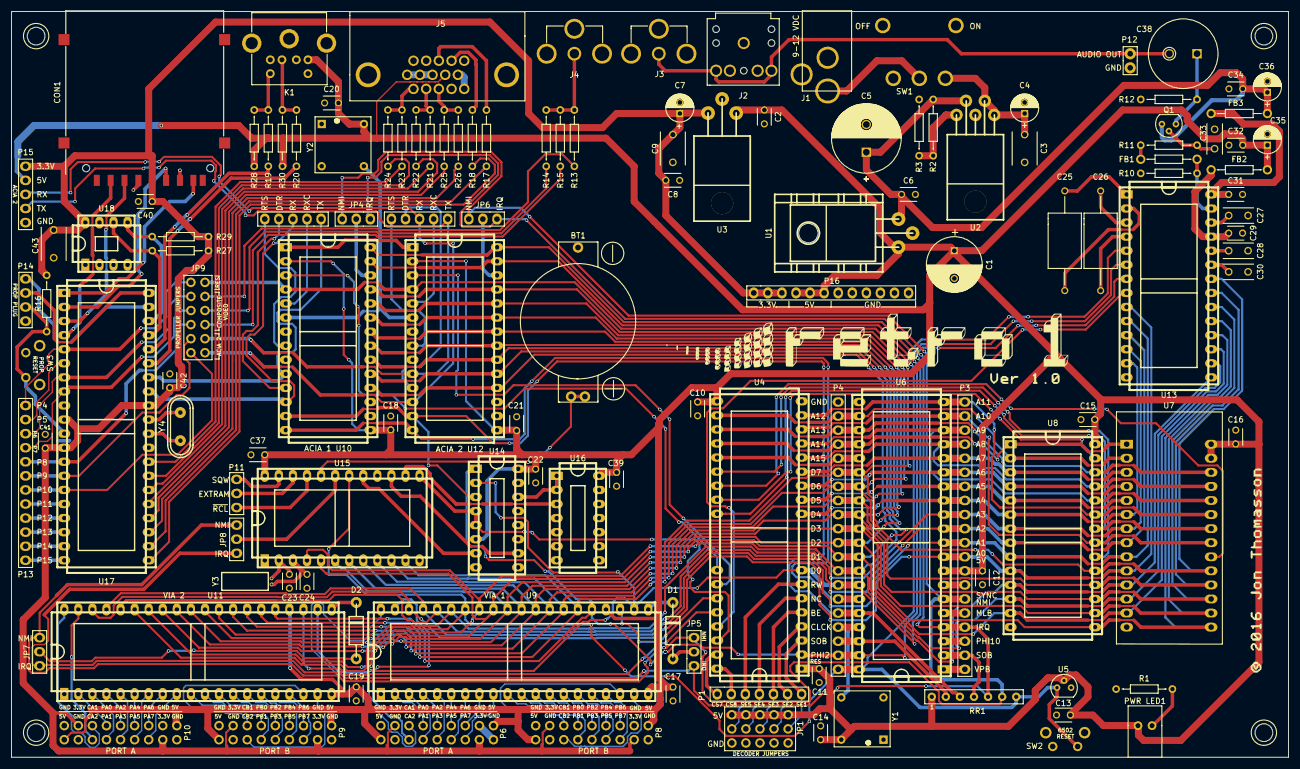
[picture p17: board 6502Computer.kicad_pcb from above]

Board: 2 copper layers, 230.5 x 134.6 mm, 130 parts (0 on the bottom side), 189 nets.

Other parts of the board:
ACIA 1 U10, ACIA 2 U12: 6551; dil_28-600_socket
PWR LED1: LED; WP1503CB_LED

Their connections:
+5V: ACIA 1 U10.2, ACIA 1 U10.15, ACIA 2 U12.2, ACIA 2 U12.15, PWR LED1.2; also elsewhere on the board
/page 2/D0: ACIA 1 U10.18, ACIA 2 U12.18; also elsewhere on the board
/page 2/D1: ACIA 1 U10.19, ACIA 2 U12.19; also elsewhere on the board
/page 2/D2: ACIA 1 U10.20, ACIA 2 U12.20; also elsewhere on the board
/page 2/D3: ACIA 1 U10.21, ACIA 2 U12.21; also elsewhere on the board
/page 2/D4: ACIA 1 U10.22, ACIA 2 U12.22; also elsewhere on the board
/page 2/D5: ACIA 1 U10.23, ACIA 2 U12.23; also elsewhere on the board
/page 2/D6: ACIA 1 U10.24, ACIA 2 U12.24; also elsewhere on the board
/page 2/D7: ACIA 1 U10.25, ACIA 2 U12.25; also elsewhere on the board
A0: ACIA 1 U10.13, ACIA 2 U12.13; also elsewhere on the board
A1: ACIA 1 U10.14, ACIA 2 U12.14; also elsewhere on the board
ACIA1_RX: ACIA 1 U10.12; also elsewhere on the board
ACIA1_TX: ACIA 1 U10.10; also elsewhere on the board
ACIA2_RX: ACIA 2 U12.12; also elsewhere on the board
ACIA2_TX: ACIA 2 U12.10; also elsewhere on the board
CS_ACIA1: ACIA 1 U10.3; also elsewhere on the board
CS_ACIA2: ACIA 2 U12.3; also elsewhere on the board
GND: ACIA 1 U10.1, ACIA 1 U10.9, ACIA 1 U10.16, ACIA 1 U10.17, ACIA 2 U12.1, ACIA 2 U12.9, ACIA 2 U12.16, ACIA 2 U12.17; also elsewhere on the board
unnamed 91: ACIA 1 U10.26; also elsewhere on the board
unnamed 92: ACIA 2 U12.26; also elsewhere on the board
unnamed 105: PWR LED1.1; also elsewhere on the board
unnamed 106: ACIA 1 U10.5; also elsewhere on the board
unnamed 107: ACIA 1 U10.11; also elsewhere on the board
unnamed 108: ACIA 1 U10.8; also elsewhere on the board
unnamed 109: ACIA 2 U12.5; also elsewhere on the board
unnamed 110: ACIA 2 U12.11; also elsewhere on the board
unnamed 111: ACIA 2 U12.8; also elsewhere on the board
unnamed 137: ACIA 1 U10.6, ACIA 2 U12.6; also elsewhere on the board
PHI2: ACIA 1 U10.27, ACIA 2 U12.27; also elsewhere on the board
RES: ACIA 1 U10.4, ACIA 2 U12.4; also elsewhere on the board
RW: ACIA 1 U10.28, ACIA 2 U12.28; also elsewhere on the board
