jonthomasson/retro1/(commit log)

2017-04-17 initial software checkin
    [aim65.cfg, applesoft.cfg, cbmbasic1.cfg, cbmbasic2.cfg, ehbasic.cfg, firmware.cfg, kb9.cfg, kbdbasic.cfg]
2017-04-17 propeller terminal code
